hxssank/spark/electronics/boost-prototype/drc-parity-report.txt

** Drc report for spark_boost_rev_a.kicad_pcb **
** Created on 2026-10-30T02:46:36 **
** Report includes: Errors, Warnings **

** Found 0 DRC violations **

** Found 0 unconnected pads **

** Found 0 Footprint errors **

** Ignored checks **
    - None

** End of Report **
