hxssank/spark/electronics/boost-prototype/erc-report.txt

ERC report (2026-10-30T02:46:34, Encoding UTF8)
Report includes: Errors, Warnings

***** Sheet /

 ** ERC messages: 0  Errors 0  Warnings 0

 ** Ignored checks:
    - Global label only appears once in the schematic
    - Four connection points are joined together
    - SPICE model issue
    - Assigned footprint doesn't match footprint filters
