hxssank/spark/electronics/boost-prototype/reports/drill-report.txt

Drill report for spark_boost_rev_a.kicad_pcb
Created on 2026-11-09T16:06:39

Copper Layer Stackup:
    =============================================================
    L1 :  F.Cu                      front
    L2 :  In1.Cu                    in1
    L3 :  In2.Cu                    in2
    L4 :  B.Cu                      back

Drill file 'spark_boost_rev_a-PTH.drl' contains
    plated through holes:
    =============================================================
    T1  0.200mm  0.0079"  (2 holes))
    T2  0.250mm  0.0098"  (29 holes))
    T3  0.300mm  0.0118"  (10 holes))
    T4  1.500mm  0.0591"  (4 holes))

    Total plated holes count 45

Drill file 'spark_boost_rev_a-NPTH.drl' contains
    unplated through holes:
    =============================================================

    Total unplated holes count 0
