hxssank/spark/sourcing/digikey-canada-bench-rev-a.csv

Reference | Quantity per board | Suggested quantity including spares | Manufacturer part number | Description | DigiKey Canada URL | Sourcing status checked 2026-10-30 | Scope
U1 | 1 | 2 | TPS61288LRQQR | Boost converter | https://www.digikey.ca/en/products/detail/texas-instruments/TPS61288LRQQR/15856656 | Listed in stock; CAD 3.31 at qty 1 | Bench boost revision A only; not a complete power bank; choose Cut Tape; PCB and assembly excluded
L1 | 1 | 2 | XAL1060-222MEC | 2.2 uH power inductor | https://www.digikey.ca/en/products/detail/coilcraft/XAL1060-222MEC/15794549 | Exact BOM part; Canada page unavailable to research tool; stock and price unverified | Bench boost revision A only; not a complete power bank; choose Cut Tape; PCB and assembly excluded
C1 C5 C6 C7 C8 C9 C10 | 7 | 10 | GRM32ER71E226KE15K | 22 uF 25 V X7R 1210 | https://www.digikey.ca/en/products/detail/murata-electronics/GRM32ER71E226KE15K/13904980 | HOLD: out of stock; K packaging variant of BOM L; effective capacitance still requires validation | Bench boost revision A only; not a complete power bank; choose Cut Tape; PCB and assembly excluded
C2 C4 | 2 | 10 | CC0402KRX7R8BB104 | 100 nF 25 V X7R 0402 | https://www.digikey.ca/en/products/detail/yageo/CC0402KRX7R8BB104/5698948 | Selected to match previously unspecified BOM value; verify checkout stock | Bench boost revision A only; not a complete power bank; choose Cut Tape; PCB and assembly excluded
C3 | 1 | 5 | 0603ZD475KAT2A | 4.7 uF 10 V X5R 0603 | https://www.digikey.ca/en/products/detail/kyocera-avx/0603ZD475KAT2A/3080849 | HOLD: listed out of stock; replacement requires VCC effective-capacitance review | Bench boost revision A only; not a complete power bank; choose Cut Tape; PCB and assembly excluded
R1 | 1 | 10 | RT0402BRD07110KL | 110 kohm 0.1% 0402 | https://www.digikey.ca/en/products/detail/yageo/RT0402BRD07110KL/5926097 | Value confirmed by DigiKey model entry; Canada stock and price unverified | Bench boost revision A only; not a complete power bank; choose Cut Tape; PCB and assembly excluded
R2 | 1 | 10 | RT0402BRD0715KL | 15 kohm 0.1% 0402 | https://www.digikey.ca/en/products/detail/yageo/RT0402BRD0715KL/5252416 | DigiKey US listing confirmed; Canada stock and price unverified | Bench boost revision A only; not a complete power bank; choose Cut Tape; PCB and assembly excluded
R3 | 1 | 10 | RT0402BRD0716K5L | 16.5 kohm 0.1% 0402 | https://www.digikey.ca/en/products/detail/yageo/RT0402BRD0716K5L/1069059 | DigiKey regional listing confirmed; Canada stock and price unverified | Bench boost revision A only; not a complete power bank; choose Cut Tape; PCB and assembly excluded
R4 | 1 | 10 | RC0402FR-0712K4L | 12.4 kohm 1% 0402 | https://www.digikey.ca/en/products/detail/yageo/RC0402FR-0712K4L/2827623 | Listed in stock; CAD 0.34 for qty 10 | Bench boost revision A only; not a complete power bank; choose Cut Tape; PCB and assembly excluded
R5 | 1 | 10 | RC0402FR-07100KL | 100 kohm 1% 0402 | https://www.digikey.ca/en/products/detail/yageo/RC0402FR-07100KL/729473 | Canada listing confirmed; verify checkout stock | Bench boost revision A only; not a complete power bank; choose Cut Tape; PCB and assembly excluded
C11 | 1 | 10 | GRM1555C1H822JE01D | 8.2 nF 50 V C0G 0402 | https://www.digikey.ca/en/products/detail/murata-electronics/GRM1555C1H822JE01D/16033667 | Canada category and regional product confirmed; verify checkout stock | Bench boost revision A only; not a complete power bank; choose Cut Tape; PCB and assembly excluded
C12 | 1 | 10 | CC0402JRNPO9BN100 | 10 pF 50 V C0G 0402 | https://www.digikey.ca/en/products/detail/yageo/CC0402JRNPO9BN100/302748 | Canada listing confirmed; verify checkout stock | Bench boost revision A only; not a complete power bank; choose Cut Tape; PCB and assembly excluded
