hxssank/spark/sourcing/parts-list.csv

id | stage | item | part_or_search_target | quantity | unit | required_spec | aliexpress_search_text | aliexpress_search_url | primary_source_url | verification | budget_line_min_cad | budget_line_max_cad | notes | price_cad | shipping_cad | tax_cad | landed_cad
B01 | sample | Battery | GNB8501S60WHV | 4 | cells | 1S1P 850mAh 3.8V LiHV; 66x18x7.7mm; A30; manufacturer advertises 60C and 1C-5C charge | GNB 850mAh 1S 3.8V 60C A30 GNB8501S60WHV | https://www.aliexpress.com/w/wholesale-GNB-850mAh-1S-3.8V-60C-A30-GNB8501S60WHV.html | https://www.gaoneng.shop/products/gaoneng-gnb-lihv-1s-3.8v-850mah-60c-a30-cabled-lipo-battery-long-range | manufacturer specification verified; supplier unverified | 40 | 65 | One small sample pack; confirm exact model and dimensions including leads; no production qualification
B02 | sample | Battery mating lead | GNB A30-F8080 or A30-F | 2 | leads | Female mating side for device; red/black polarity verified by meter; adequate wire gauge for measured current | GNB A30 F8080 female cable connector | https://www.aliexpress.com/w/wholesale-GNB-A30-F8080-female-cable-connector.html | https://www.gaoneng.shop/products/gaoneng-a30-connector-adapter-for-fpv-whoops-quads-lipo-battery | manufacturer variant verified; wire rating unresolved | 8 | 15 | A30 joint and supplied leads need temperature and voltage-drop measurement; do not assume a connector current from C rating
B03 | sample | Charging adapter | GNB A30-PH2.0 | 1 | adapter | A30 female to PH2.0 male; charging only at 0.8A | GNB A30 PH2.0 charging adapter | https://www.aliexpress.com/w/wholesale-GNB-A30-PH2.0-charging-adapter.html | https://www.gaoneng.shop/products/gaoneng-a30-connector-adapter-for-fpv-whoops-quads-lipo-battery | manufacturer variant verified; supplier unverified | 4 | 8 | Never put PH2.0 adapter in high-current discharge path
B04 | sample | Short phone cable | USB-C to USB-C 60W 3A | 1 | cable | 0.15-0.3m; 3A rating; both CC orientations pass PD testing | USB C to USB C 60W 3A 0.2m cable | https://www.aliexpress.com/w/wholesale-USB-C-to-USB-C-60W-3A-0.2m-cable.html |  | procurement requirement; seller unverified | 6 | 12 | Select a known brand and verify cable voltage drop; no magnetic tip
B05 | sample | Insulation | Polyimide tape and electrical-grade fishpaper | 1 | small set | 0.1-0.3mm fishpaper plus tape; use in insulation allowance | battery fish paper insulation 0.2mm polyimide tape | https://www.aliexpress.com/w/wholesale-battery-fish-paper-insulation-0.2mm-polyimide-tape.html |  | procurement requirement; seller unverified | 8 | 15 | Insulate cell and PCB from eventual aluminium; avoid compressing pouch
B06 | sample | Wire | 20AWG stranded silicone copper | 1 | small red black set | Short flexible battery leads; actual conductor cross-section checked | 20AWG silicone copper wire red black | https://www.aliexpress.com/w/wholesale-20AWG-silicone-copper-wire-red-black.html |  | procurement requirement; seller unverified | 8 | 15 | Keep high-current loop short; gauge does not replace measured connector temperature
B07 | sample | Printed enclosure material | PETG | 1 | prototype allocation | Use existing filament if suitable; cold fit first | PETG 1.75mm filament black | https://www.aliexpress.com/w/wholesale-PETG-1.75mm-filament-black.html |  | procurement requirement; seller unverified | 5 | 10 | Prototype material allocation, not a spool quote; printed case is not thermal validation
B08 | sample | Case fasteners | M2x3 socket-head cap screw | 10 | screws | 2 used; head diameter about3.8mm; head height at most2mm; length3mm | M2x3 socket head cap screw | https://www.aliexpress.com/w/wholesale-M2x3-socket-head-cap-screw.html |  | CAD requirement; seller unverified | 6 | 10 | Printed carrier blind1.6mm pilots; no heat-set inserts in fit prototype
T01 | tools_if_missing | Cell charger | VIFLY WhoopStor 3 | 1 | charger | 0.3-1.3A per port; 4.20V and 4.35V; storage mode; PH2.0/BT2.0 | VIFLY WhoopStor 3 | https://www.aliexpress.com/w/wholesale-VIFLY-WhoopStor-3.html | https://viflydrone.com/products/vifly-whoopstor-6-ports-1s-battery-storage-charger-discharger | manufacturer specification verified; supplier unverified | 45 | 70 | Initial plan 0.8A and 4.20V; official product page showed selected variant sold out
T02 | tools_if_missing | Charger power source | USB-C PD 45W or greater | 1 | adapter | Must meet WhoopStor input 9-20V and minimum40W; verify actual offered profiles with charger; 12V profile preferred | USB C PD 65W charger 12V 15V 20V | https://www.aliexpress.com/w/wholesale-USB-C-PD-65W-charger-12V-15V-20V.html | https://viflydrone.com/products/vifly-whoopstor-6-ports-1s-battery-storage-charger-discharger | charger input verified; source SKU unselected | 25 | 45 | Reuse compatible source; a 5V-only USB source cannot operate WhoopStor
T03 | tools_if_missing | Charger cable | USB-C to USB-C 60W 3A | 1 | cable | 0.5-1m; 3A and proper CC wiring | USB C to USB C 60W 3A cable | https://www.aliexpress.com/w/wholesale-USB-C-to-USB-C-60W-3A-cable.html |  | procurement requirement; seller unverified | 6 | 12 | Separate from short phone cable
T04 | tools_if_missing | USB PD meter and trigger | FNIRSI FNB58 | 1 | meter | Manufacturer specifies4-28V and0-7A; PD trigger and energy logging | FNIRSI FNB58 USB tester | https://www.aliexpress.com/w/wholesale-FNIRSI-FNB58-USB-tester.html | https://www.fnirsi.com/products/fnb58 | manufacturer specification verified; supplier unverified | 55 | 85 | Protocol triggers connect to test load, never blindly to phone; meter is not an electronic load
T05 | tools_if_missing | DC electronic load | ATORCH DL24 150W | 1 | load kit | Manufacturer manual specifies2-200V0-20A; choose correct DL24 variant and required auxiliary supply | ATORCH DL24 150W electronic load kit | https://www.aliexpress.com/w/wholesale-ATORCH-DL24-150W-electronic-load-kit.html | https://en.atorch.cn/upload/20241224153104.pdf | manufacturer manual indexed; live PDF fetch timed out; supplier unverified | 45 | 80 | Budget includes auxiliary supply allowance; verify constant-current operation and leads before battery test
T06 | tools_if_missing | Contact thermometer | UNI-T UT320D | 1 | meter with two probes | Dual K/J input; insulate conductive probe beads from exposed conductors | UNI T UT320D dual thermocouple | https://www.aliexpress.com/w/wholesale-UNI-T-UT320D-dual-thermocouple.html | https://meters.uni-trend.com/product/ut320-series | manufacturer specification verified; supplier unverified | 35 | 60 | Measure cell and converter; case/connector in separate repeated runs or add logger
H01 | hold | Custom power electronics | See electronics/power-design.md | 1 | development design | Minimum25W at USB-C after losses; 1S input; charger/protection/thermal control required | 1S 30W USB C PD power bank module schematic | https://www.aliexpress.com/w/wholesale-1S-30W-USB-C-PD-power-bank-module-schematic.html |  | circuit selection and PCB review required |  |  | Generic module search is for comparison only; no module qualified to fit or meet output target
H02 | hold | PCB fabrication and assembly | Custom board | 1 | prototype lot | Copper weight, layer count, stencil, assembly and test set by final electrical design |  |  |  | not released for fabrication |  |  | Get fabrication quote only after circuit and layout review; excludes machining and laboratory certification
H03 | hold | Bench supply for board bring-up | Current-limited adjustable supply | 1 | supply if missing | At least0-5V and10A for full-power1S emulation; output-off control; reverse-current handling reviewed |  |  |  | requirement only; no qualified SKU |  |  | Do not connect charging output to a source-only supply without blocking or suitable battery simulator
D01 | hold | Colour OLED glass | RB060-6464TDDBG01 | 1 | set | 15x17.5x1.2mm nominal glass; active10.73x10.73mm;64x64RGB;SPI;20pin0.5mm FPC |  |  | https://www.ronboe.com/shop/rb060-6464tddbg01/ | Manufacturer listing checked2026-10-28; drawing and sample required |  |  | Rear PCB bay candidate; supply rails,pinout,tail,maximum dimensions,stock,lifecycle and landed cost unverified
D02 | hold | Battery fuel gauge | MAX17260 TDFN plus Kelvin shunt and NTC | 1 | set | 3x3mm TDFN;1mohm current sense candidate; pair learned state with identified cell |  |  | https://www.analog.com/media/en/technical-documentation/data-sheets/max17260.pdf | Architecture candidate; not on boost PCB |  |  | Gauge belongs with identified protected cartridge; A30 alone does not identify a swapped cell; health unknown until learned
D03 | hold | Display control and power | Low-power SPI MCU and gated OLED supply | 1 | set | MCU with SPI and I2C; panel rails match exact supplier datasheet; button wake; power budget measured |  |  |  | Requirements only; no SKU selected |  |  | Reserve connector,decoupling,power sequencing and firmware; no functional screen electronics implemented
D04 | hold | Display lens and mounting | Clear insulating lens and removable frame | 1 | set | Fit exact panel maximum envelope; lens stays with sleeve and panel with carrier; sleeve slides down without unplugging display; no pressure on cell |  |  |  | CAD candidate; sample fit required |  |  | CAD service path tested; actual flex route,adhesion,impact resistance and button access remain unverified
N01 | hold | Thin power inductor | XGL7030-222MEC | 1 | candidate | 2.2uH; maximum body8x8x3.1mm; maxDCR8.8mohm; Isat30percent14.5A |  |  | https://www.coilcraft.com/getmedia/63e6e233-cff1-40b9-9e5d-f0f490094f44/xgl7030.pdf | Manufacturer documentation checked2026-10-29; research candidate; not on routed PCB |  |  | First thin-coil experiment; requires tighter overload limit or saturation qualification; hot winding and enclosed temperature untested
N02 | hold | Lower-loss smaller-area inductor alternative | XGL6060-222MEC | 1 | candidate | 2.2uH; maximum body6.91x6.71x6.1mm; maxDCR4.8mohm; Isat30percent16A |  |  | https://www.coilcraft.com/getmedia/329fe97c-7311-4726-9bf3-37718f42b168/xgl6060.pdf | Manufacturer documentation checked2026-10-29; research candidate; not on routed PCB |  |  | Alternative to N01; reduces area but not height; fault current and temperature require qualification
N03 | hold | Smaller capacitor candidate | C2012X5R1E226M125AC |  | candidate | 22uF25V X5R0805; tolerance20percent; maximum body2.2x1.45x1.45mm |  |  | https://product.tdk.com/en/search/capacitor/ceramic/mlcc/info?part_no=C2012X5R1E226M125AC | Manufacturer documentation checked2026-10-29; research candidate; not on routed PCB |  |  | Quantity unresolved; output bank must retain at least60uF effective at9V after derating; input substitution also needs ripple verification
N04 | hold | Smaller capacitor alternative | GRM21BR61E226ME44L |  | candidate | 22uF25V X5R0805; tolerance20percent; maximum body2.2x1.45x1.45mm |  |  | https://search.murata.co.jp/Ceramy/image/img/A01X/G101/ENG/GRM21BR61E226ME44-01A.pdf | Manufacturer documentation checked2026-10-29; research candidate; not on routed PCB |  |  | Alternative to N03; quantity and effective capacitance unresolved; no six-part replacement approval
N05 | hold | Combined display and USB-PD MCU | STM32G071GBU6N | 1 | candidate | 4x4mm UFQFPN28;128KBflash;36KBRAM;SPI;I2C;UCPD |  |  | https://www.st.com/en/microcontrollers-microprocessors/stm32g071gb.html | Manufacturer documentation checked2026-10-29; research candidate; not on routed PCB |  |  | Use N pinout with bothCC pins; requires firmware and hardware fault shutdown; pin allocation and low-power supply not designed
N06 | hold | Source-only USB-C protection and gate driver | TCPP02-M18 | 1 | candidate | 3.5x3.5x0.55mm; CC protection; external VBUS FET driver and discharge |  |  | https://www.st.com/resource/en/datasheet/tcpp02-m18.pdf | Manufacturer documentation checked2026-10-29; research candidate; not on routed PCB |  |  | For source-only external-dock architecture with N05; external FETs and sensing remain
N07 | hold | Dual-role USB-C protection and gate driver alternative | TCPP03-M20 | 1 | candidate | 4x4x0.75mm; source and sink external NFET drivers; CC protection; discharge |  |  | https://www.st.com/resource/en/datasheet/tcpp03-m20.pdf | Manufacturer documentation checked2026-10-29; research candidate; not on routed PCB |  |  | Alternative to N06 if same port charges and supplies phone; interlocks and reverse-current blocking require design
N08 | hold | Optional onboard switching charger | BQ25628RYKR | 1 | candidate | 2.5x3mm WQFN;0.04-2A charge;3.50-4.80V regulation;1.5MHz |  |  | https://www.ti.com/lit/ds/symlink/bq25628.pdf | Manufacturer documentation checked2026-10-29; research candidate; not on routed PCB |  |  | Needs inductor and capacitors; main boost must bypass6A SYS battery path and use independently protected pack; charge ceiling includes tolerance; separate boost isolation needed because charger ship mode cannot disconnect it; inhibit charger during USB source mode
N09 | hold | Smaller existing fuel gauge package | MAX17260SEWL+T | 1 | candidate | 1.5x1.5mm9-WLP;0.4mm pitch;1mohm Kelvin shunt candidate |  |  | https://www.analog.com/media/en/technical-documentation/data-sheets/max17260.pdf | Manufacturer documentation checked2026-10-29; research candidate; not on routed PCB |  |  | Alternative package to D02;75percent chip-area reduction; separate protection and cartridge identity still required
N10 | hold | Integrated smart-cartridge gauge and protector alternative | MAX17311X+T | 1 | candidate | 1.7x2.5mm15-WLP;0.5mm pitch;1-Wire;64-bit uniqueID;standalone protection |  |  | https://www.analog.com/media/en/technical-documentation/data-sheets/max17300-max17313.pdf | Manufacturer documentation checked2026-10-29; research candidate; not on routed PCB |  |  | Alternative to separate MAX17260 and BQ2980; external FETs shunt NTC remain; verify configuration;24uAactive18uAhibernate; requires data contact
N11 | hold | Separate single-cell protector alternative | BQ2980 family; order code pending battery | 1 | candidate | 1.5x1.5x0.37mm;high-side NFET drive;separate current shunt |  |  | https://www.ti.com/lit/ds/symlink/bq2980.pdf | Manufacturer documentation checked2026-10-29; research candidate; not on routed PCB |  |  | Use with N09 instead of N10; fixed voltage thresholds and shunt must match selected cell; BQ298018 with 4.4 V OVP is not a universal choice
N12 | hold | Battery protection dual MOSFET candidate | SSM10N954L | 1 | candidate | 2.98x1.49x0.11mm;common-drain dualNFET;RSSmax2.75mohm atVgs4.5V25C |  |  | https://toshiba.semicon-storage.com/info/SSM10N954L_datasheet_en_20231010.pdf?did=70605&prodName=SSM10N954L | Manufacturer documentation checked2026-10-29; research candidate; not on routed PCB |  |  | Verify protector gate-drive compatibility and short-circuit behavior;13.5A absolute rating is not Spark continuous rating; assembly capability unverified
N13 | hold | Compact USB-C receptacle | USB4500-03-0-A | 1 | candidate | 6.50mm body length;3.16mm profile;0.80mm midmount offset;5AcollectiveVBUS |  |  | https://gct.co/connector/usb4500 | Manufacturer documentation checked2026-10-29; research candidate; not on routed PCB |  |  | Product page verified; drawing retrieval failed; width land pattern board cutout and1mmPCB compatibility unresolved
N14 | hold | Conditional OLED boost supply | TPS61046YFFR | 1 | candidate | 0.80x1.20mm nominalWCSP;output through28V;fixed12V option;true shutdown disconnect |  |  | https://www.ti.com/lit/ds/symlink/tps61046.pdf | Manufacturer documentation checked2026-10-29; research candidate; not on routed PCB |  |  | Requires exact Ronbo electrical specification; not confirmation panel needs12V; needs inductor and capacitors; check current and sequencing
N15 | hold | Lower-power integrated charger and boost alternative | BQ25638 | 1 | candidate | 2.07x2.36mm DSBGA;3.84-9.6Vboost;7A maximum recommended continuous battery discharge |  |  | https://www.ti.com/lit/ds/symlink/bq25638.pdf | Manufacturer documentation checked2026-10-29; research candidate; not on routed PCB |  |  | Separate approximately15W evaluation only; cannot sustain25W from3V cell; may replace two converters and inductors with one each
