hxssank/spark/mechanical/exports/spark_assembly.step

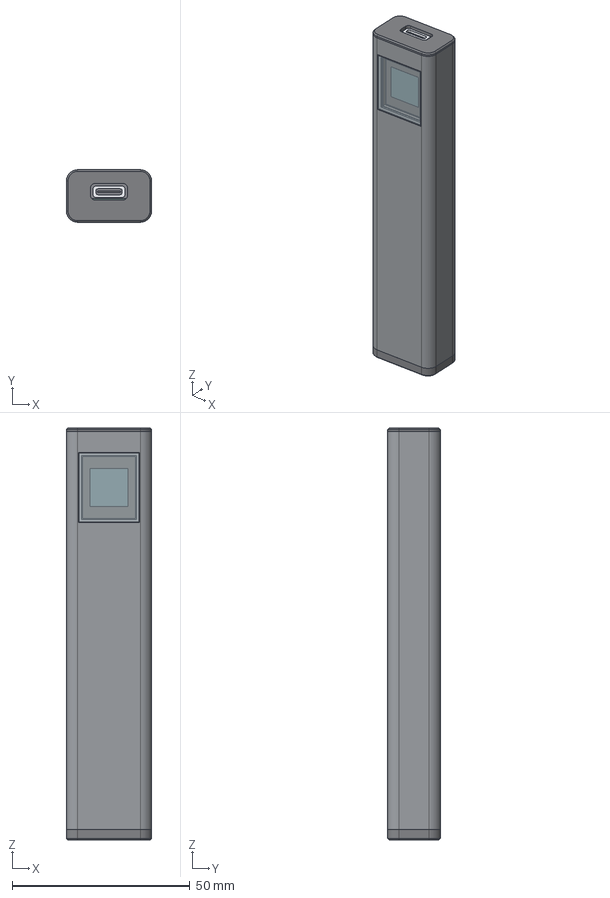
[picture p2: CAD file, 2026-11-09]
mechanical/exports/spark_assembly.step
24.0 x 14.8 x 116.0 mm
u1_reference
inductor_reference
input_cap_reference
c2_unmeasured_reference
c3_unmeasured_reference
c4_unmeasured_reference
c5_reference
c6_reference
c7_reference
c8_reference
c9_reference
c10_reference
r1_unmeasured_reference
r2_unmeasured_reference
r3_unmeasured_reference
jp1_pad_reference
r4_unmeasured_reference
c11_unmeasured_reference
c12_unmeasured_reference
r5_unmeasured_reference
j1_pad_reference
j2_pad_reference
j3_pad_reference
j4_pad_reference
j5_pad_reference
a30_unmeasured_reference
display_glass_reference
display_active_reference
display_lens_reference
display_fpc_keepout_reference
sleeve
carrier
front_cover
bottom_cap
battery_reference
pcb_reference
usb_reference
usb_tongue_reference
