hxssank/spark/mechanical/exports/usb_reference.step

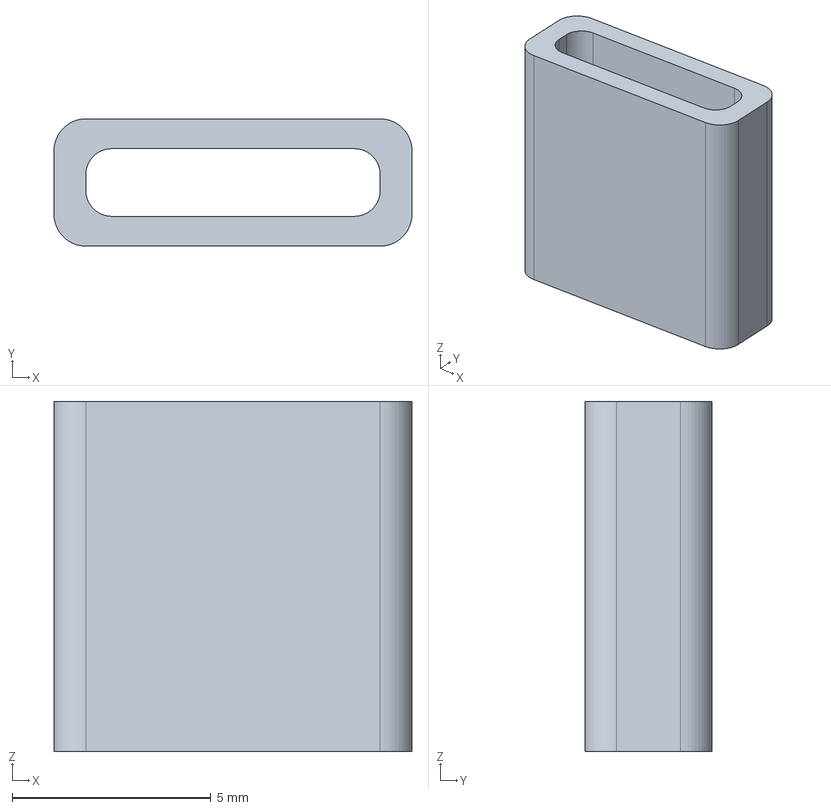
[picture p4: CAD file, 2026-11-09]
mechanical/exports/usb_reference.step
9.00 x 3.20 x 8.80 mm
