hxssank/spark/mechanical/exports/j5_pad_reference.step

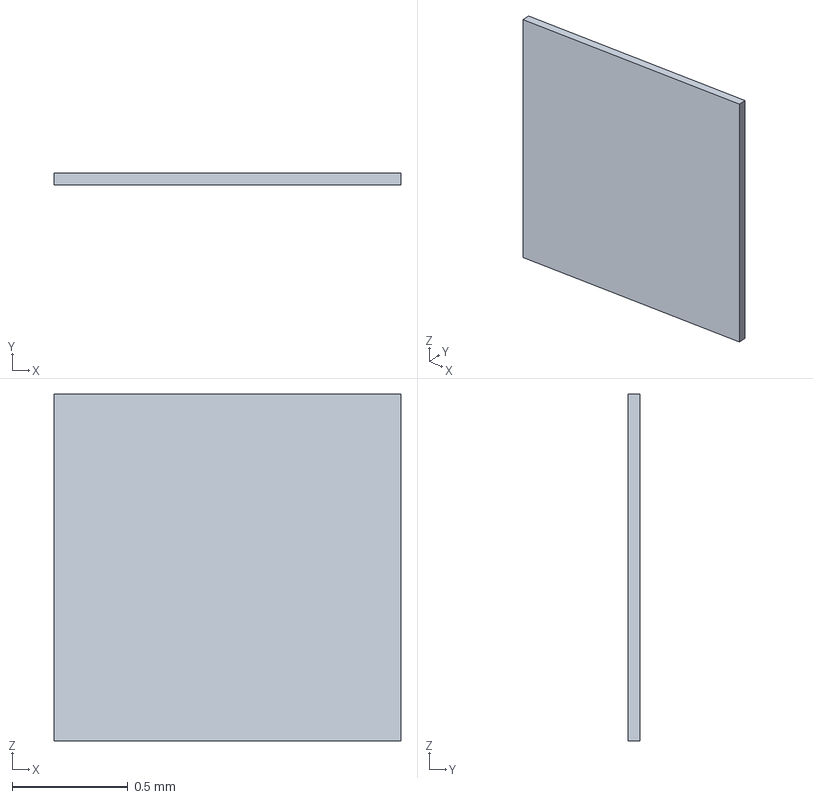
[picture p6: CAD file, 2026-11-09]
mechanical/exports/j5_pad_reference.step
1.50 x 0.05 x 1.50 mm
