hxssank/spark/mechanical/compact-exports/spark_300_packing.step

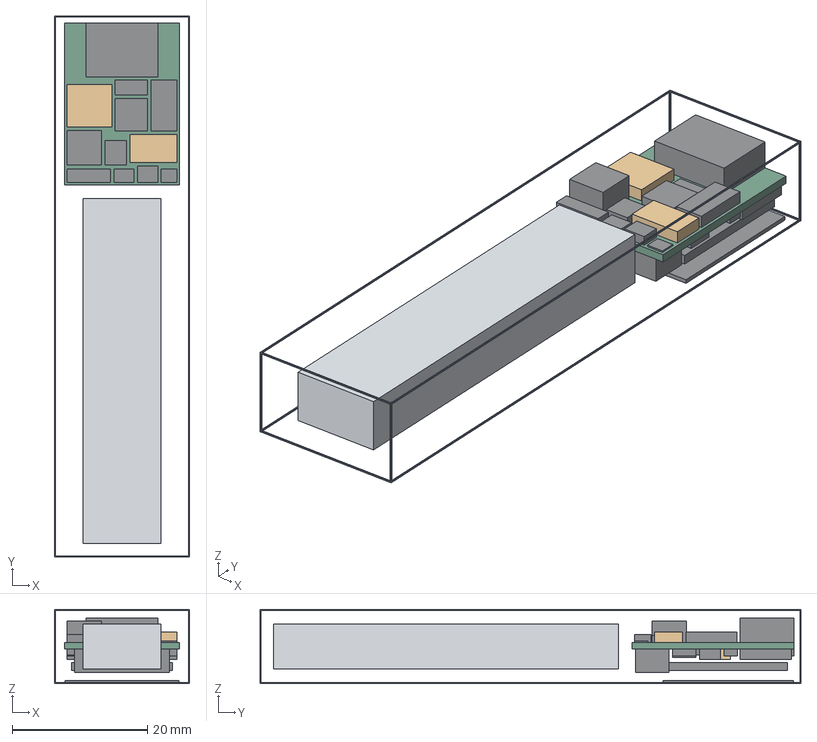
[picture p7: CAD file, 2026-11-09]
mechanical/compact-exports/spark_300_packing.step
20.0 x 80.0 x 11.0 mm
case_envelope_frame
cell_envelope
board_reservation
JBAT_front_reservation
RSBAT_front_reservation
QBAT_front_reservation
TH_front_reservation
L1_front_reservation
U1_front_reservation
CIN_front_reservation
COUT_front_reservation
MCU_front_reservation
SUP1_front_reservation
TEST_front_reservation
USB_front_reservation
USB_back_reservation
FPC_back_reservation
PD_back_reservation
QUSB_back_reservation
RSUSB_back_reservation
PACK_back_reservation
OLED_back_reservation
LOLED_back_reservation
COLED_back_reservation
LDO_back_reservation
WAKE_back_reservation
SUP2_back_reservation
SUP3_back_reservation
display_glass_reservation
display_lens_reservation
