hxssank/spark/mechanical/exports/c9_reference.step

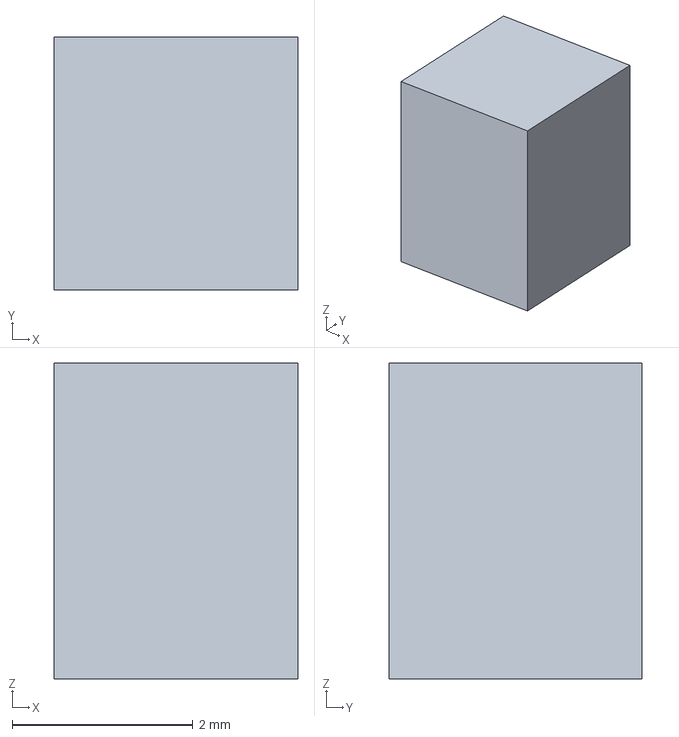
[picture p8: CAD file, 2026-11-09]
mechanical/exports/c9_reference.step
2.70 x 2.80 x 3.50 mm
