hxssank/spark/mechanical/exports/front_cover.step

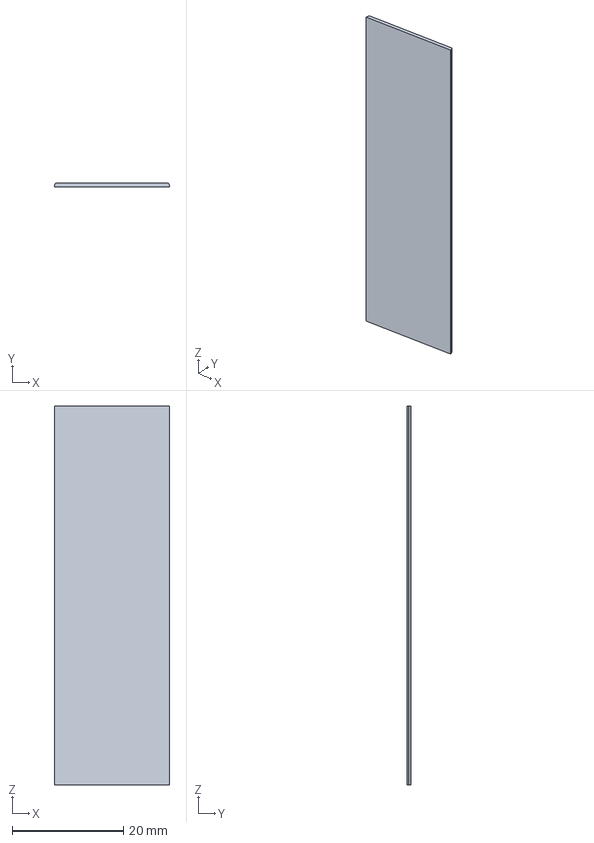
[picture p9: CAD file, 2026-11-09]
mechanical/exports/front_cover.step
20.7 x 0.8 x 68.0 mm
