hxssank/spark/mechanical/exports/inductor_reference.step

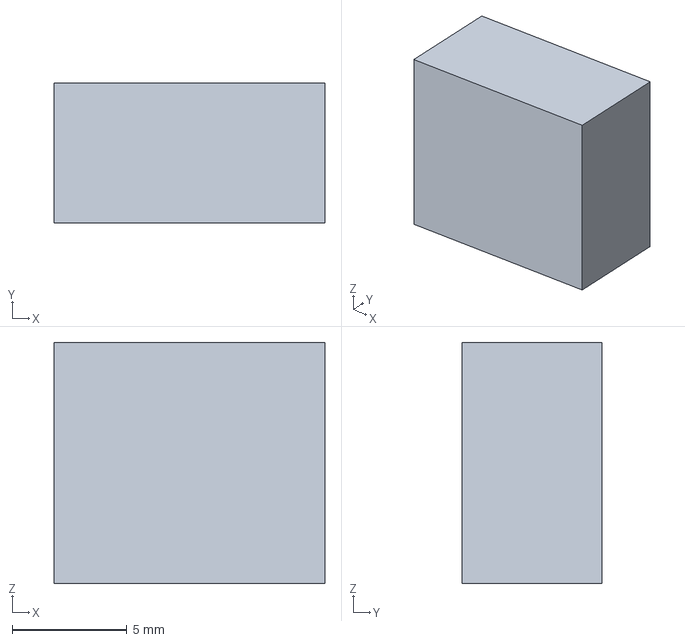
[picture p10: CAD file, 2026-11-09]
mechanical/exports/inductor_reference.step
11.8 x 6.10 x 10.5 mm
