hxssank/spark/mechanical/exports/c4_unmeasured_reference.step

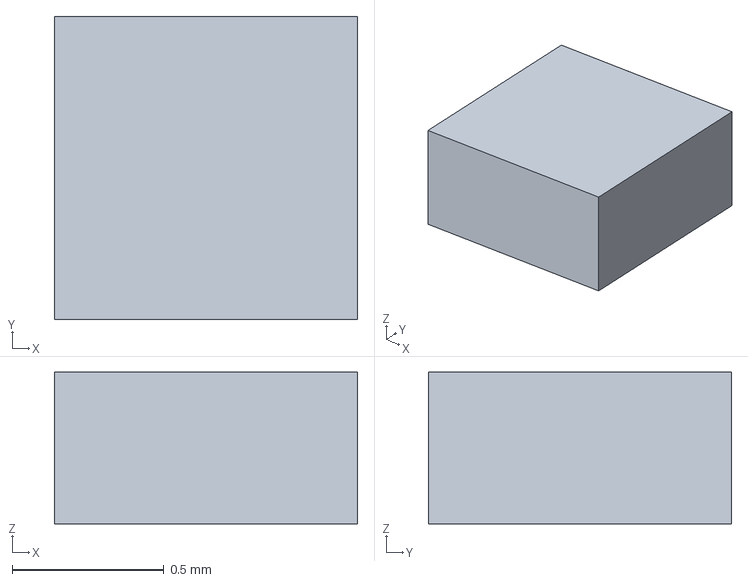
[picture p11: CAD file, 2026-11-09]
mechanical/exports/c4_unmeasured_reference.step
1.00 x 1.00 x 0.5 mm
