hxssank/spark/mechanical/exports/display_active_reference.step

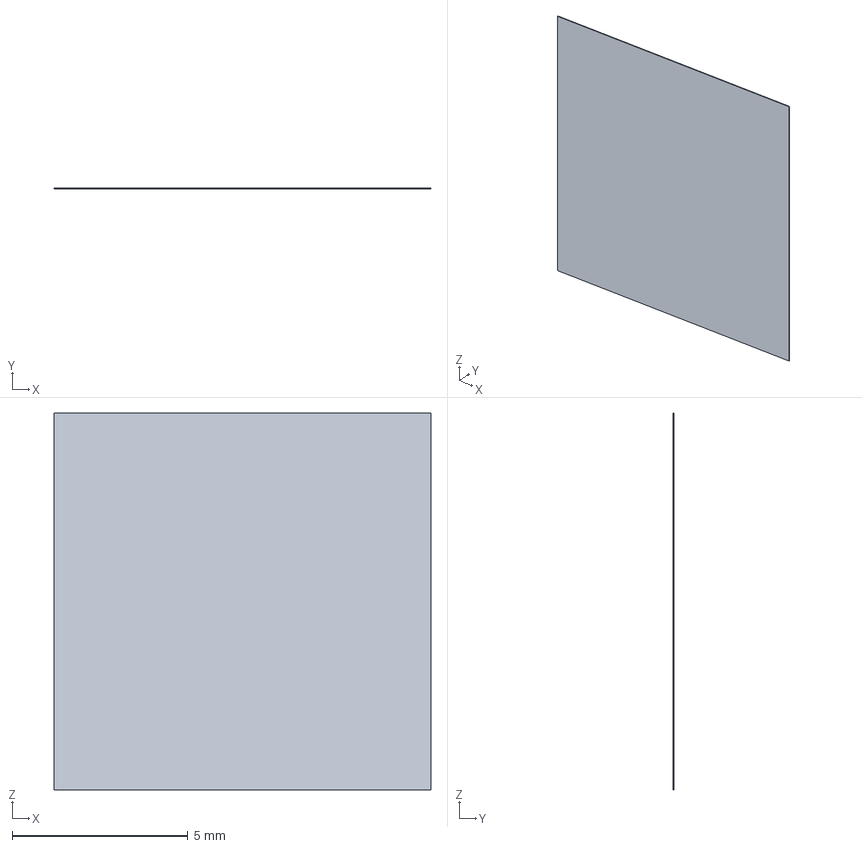
[picture p12: CAD file, 2026-11-09]
mechanical/exports/display_active_reference.step
10.7 x 0.03 x 10.7 mm
