hxssank/spark/mechanical/exports/battery_reference.step

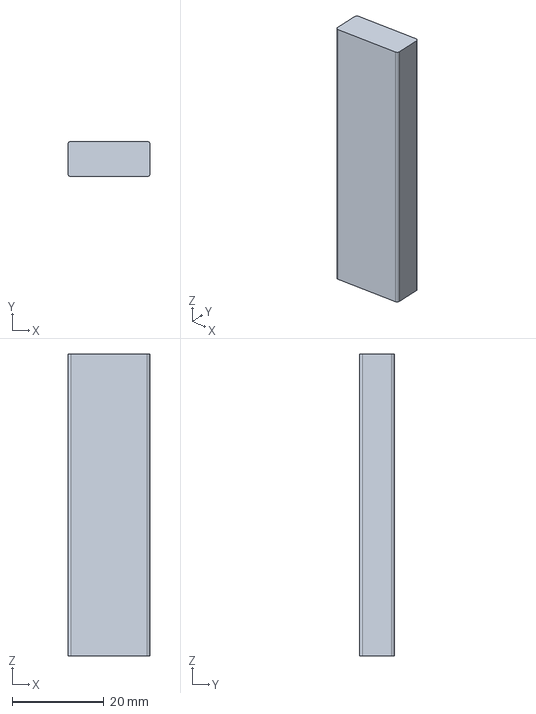
[picture p13: CAD file, 2026-11-09]
mechanical/exports/battery_reference.step
18.0 x 7.70 x 66.0 mm
