hxssank/spark/mechanical/exports/j2_pad_reference.step

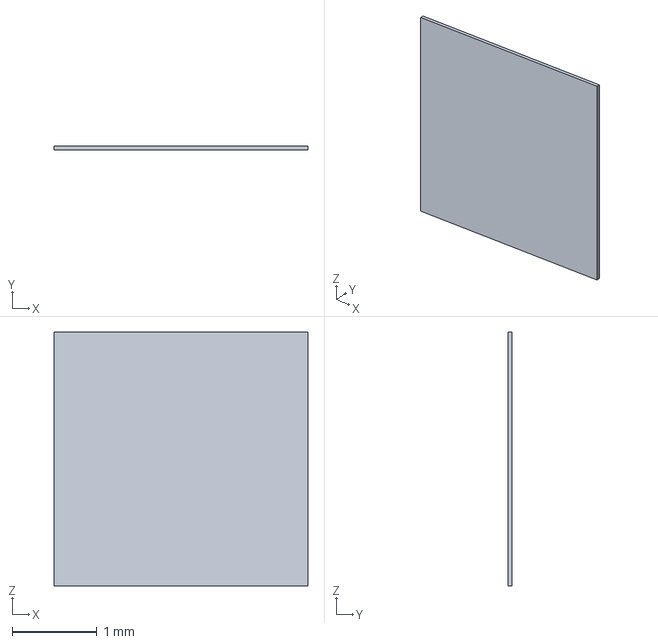
[picture p14: CAD file, 2026-11-09]
mechanical/exports/j2_pad_reference.step
3.00 x 0.05 x 3.00 mm
