hxssank/spark/mechanical/exports/pcb_reference.step

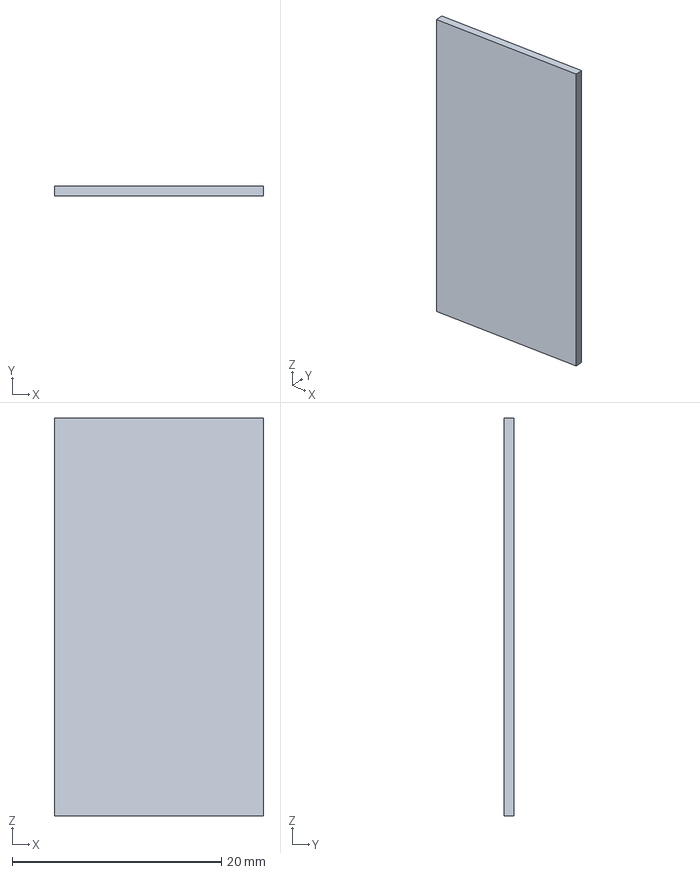
[picture p15: CAD file, 2026-11-09]
mechanical/exports/pcb_reference.step
20.0 x 1.00 x 38.0 mm
