hxssank/spark/mechanical/exports/carrier.step

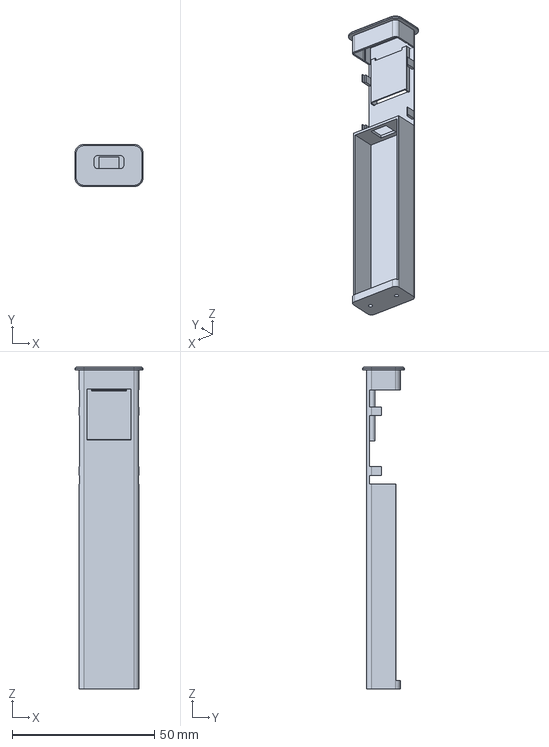
[picture p16: CAD file, 2026-11-09]
mechanical/exports/carrier.step
24.0 x 14.8 x 113.0 mm
