hxssank/spark/mechanical/exports/sleeve.step

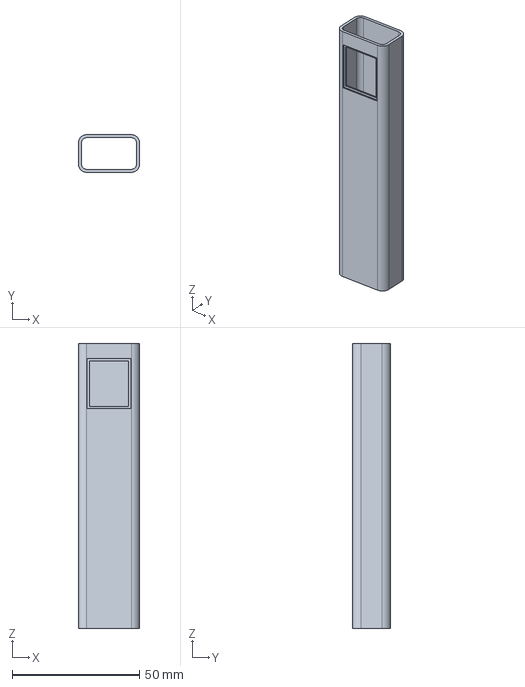
[picture p17: CAD file, 2026-11-09]
mechanical/exports/sleeve.step
24.0 x 14.8 x 112.0 mm
