hxssank/spark/mechanical/exports/u1_reference.step

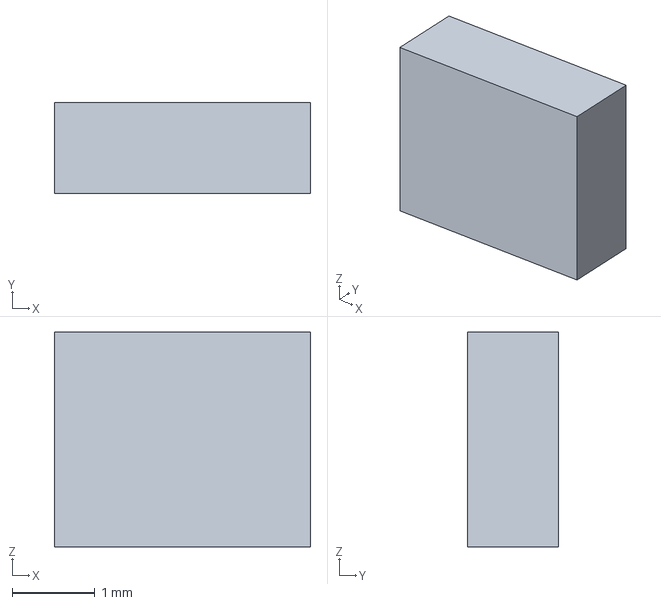
[picture p18: CAD file, 2026-11-09]
mechanical/exports/u1_reference.step
3.10 x 1.10 x 2.60 mm
