hxssank/spark/mechanical/exports/display_lens_reference.step

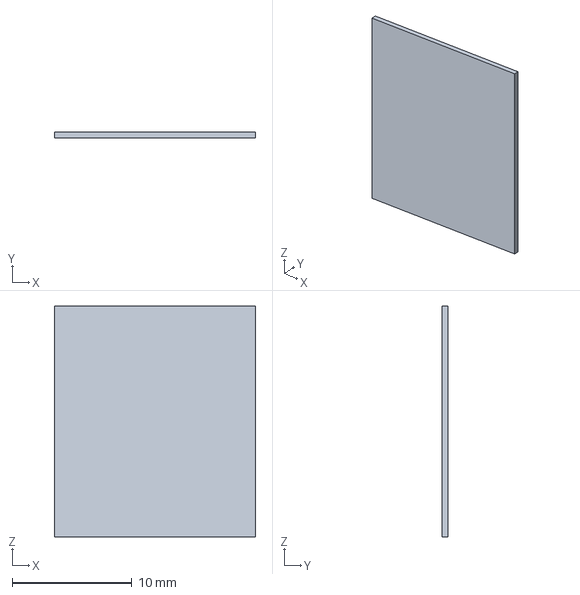
[picture p19: CAD file, 2026-11-09]
mechanical/exports/display_lens_reference.step
16.8 x 0.5 x 19.3 mm
