hxssank/spark/mechanical/exports/jp1_pad_reference.step

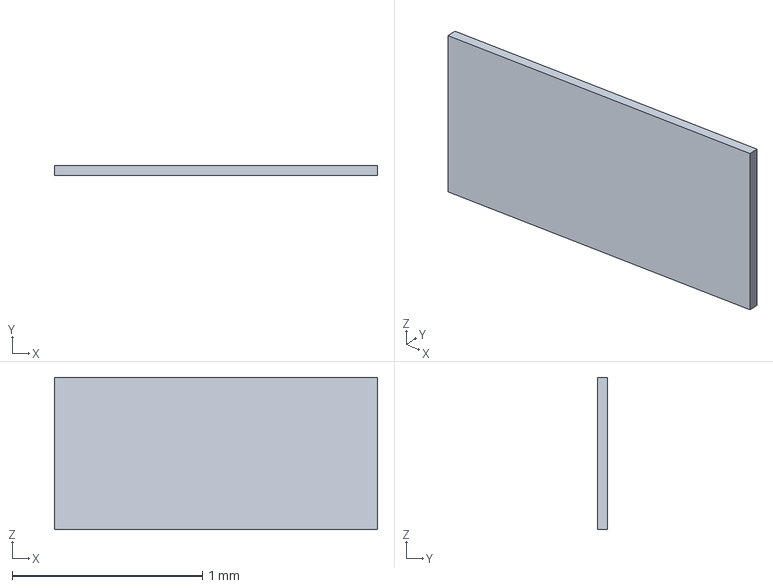
[picture p20: CAD file, 2026-11-09]
mechanical/exports/jp1_pad_reference.step
1.70 x 0.05 x 0.8 mm
