hxssank/spark/mechanical/exports/c3_unmeasured_reference.step

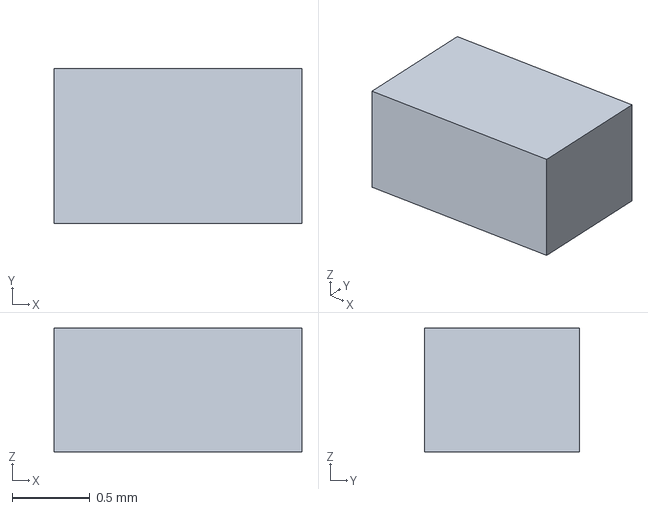
[picture p21: CAD file, 2026-11-09]
mechanical/exports/c3_unmeasured_reference.step
1.60 x 1.00 x 0.8 mm
