hxssank/spark/mechanical/exports/a30_unmeasured_reference.step

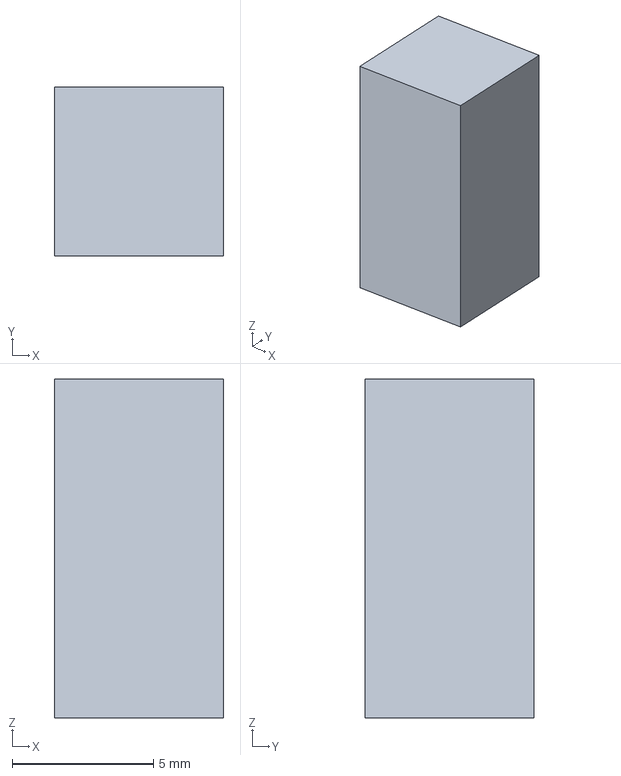
[picture p22: CAD file, 2026-11-09]
mechanical/exports/a30_unmeasured_reference.step
6.00 x 6.00 x 12.0 mm
