hxssank/spark/mechanical/exports/display_fpc_keepout_reference.step

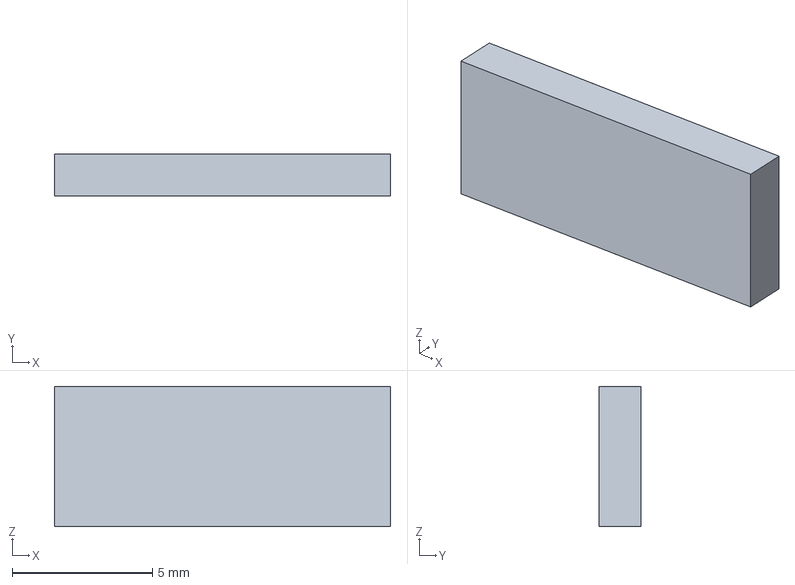
[picture p23: CAD file, 2026-11-09]
mechanical/exports/display_fpc_keepout_reference.step
12.0 x 1.50 x 5.00 mm
