hxssank/spark/mechanical/exports/usb_tongue_reference.step

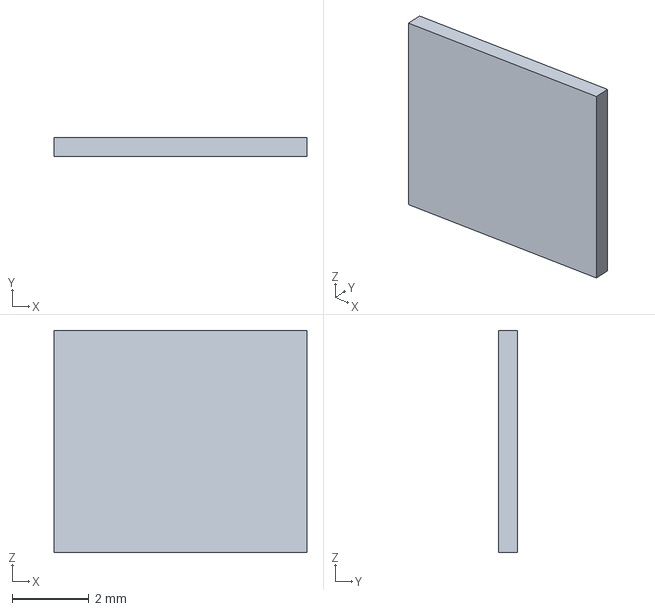
[picture p24: CAD file, 2026-11-09]
mechanical/exports/usb_tongue_reference.step
6.60 x 0.5 x 5.80 mm
