hxssank/spark/mechanical/exports/bottom_cap.step

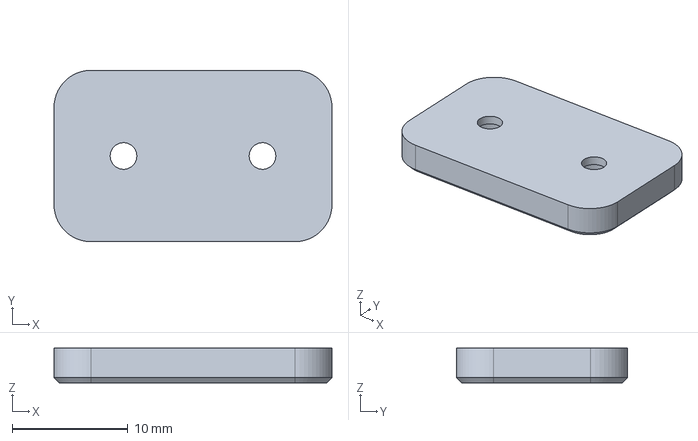
[picture p25: CAD file, 2026-11-09]
mechanical/exports/bottom_cap.step
24.0 x 14.8 x 3.00 mm
