hxssank/spark/mechanical/exports/display_glass_reference.step

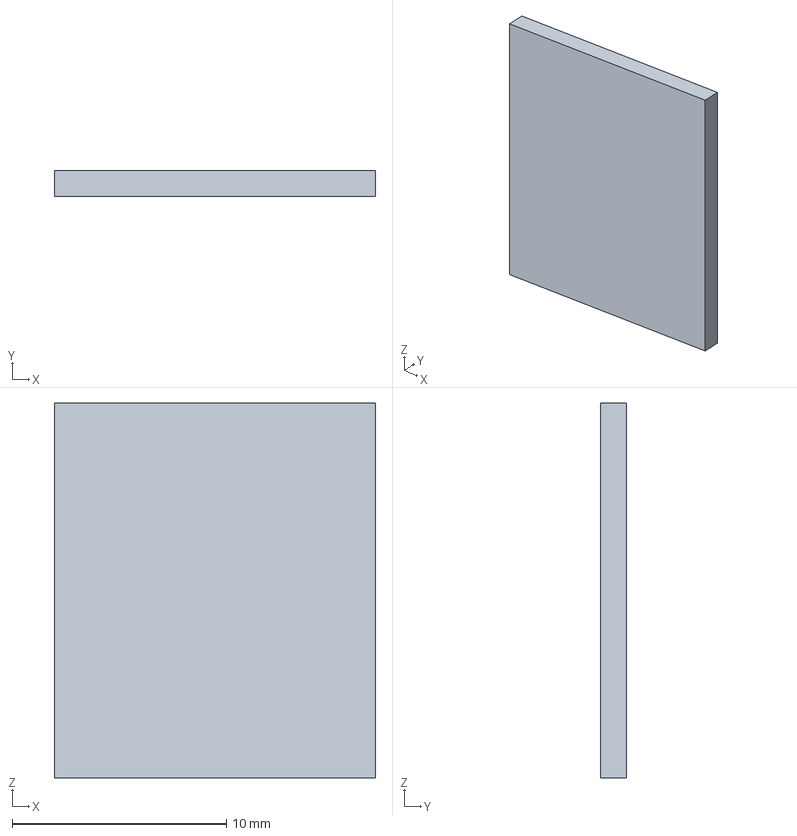
[picture p26: CAD file, 2026-11-09]
mechanical/exports/display_glass_reference.step
15.0 x 1.20 x 17.5 mm
