hxssank/spark/(list of files, cad)

Other CAD files:
mechanical/exports/c8_reference.step
mechanical/exports/c2_unmeasured_reference.step
mechanical/exports/j1_pad_reference.step
mechanical/exports/r3_unmeasured_reference.step
mechanical/exports/r2_unmeasured_reference.step
mechanical/exports/r4_unmeasured_reference.step
mechanical/exports/c10_reference.step
mechanical/exports/j3_pad_reference.step
mechanical/exports/c5_reference.step
mechanical/exports/input_cap_reference.step
mechanical/exports/c11_unmeasured_reference.step
mechanical/exports/c6_reference.step
mechanical/exports/r5_unmeasured_reference.step
mechanical/exports/j4_pad_reference.step
mechanical/exports/c7_reference.step
mechanical/exports/r1_unmeasured_reference.step
mechanical/exports/c12_unmeasured_reference.step
mechanical/print_parts/bottom_cap.stl
mechanical/print_parts/carrier.stl
mechanical/print_parts/front_cover.stl
mechanical/print_parts/sleeve.stl
