hxssank/spark/(list of files, drawings)

Other design files:
electronics/boost-prototype/reports/pcb-drc.json
