hxssank/spark/electronics/boost-prototype/spark_boost_rev_a.kicad_pcb

## KiCad design electronics/boost-prototype/spark_boost_rev_a.kicad_pcb (2026-11-09)

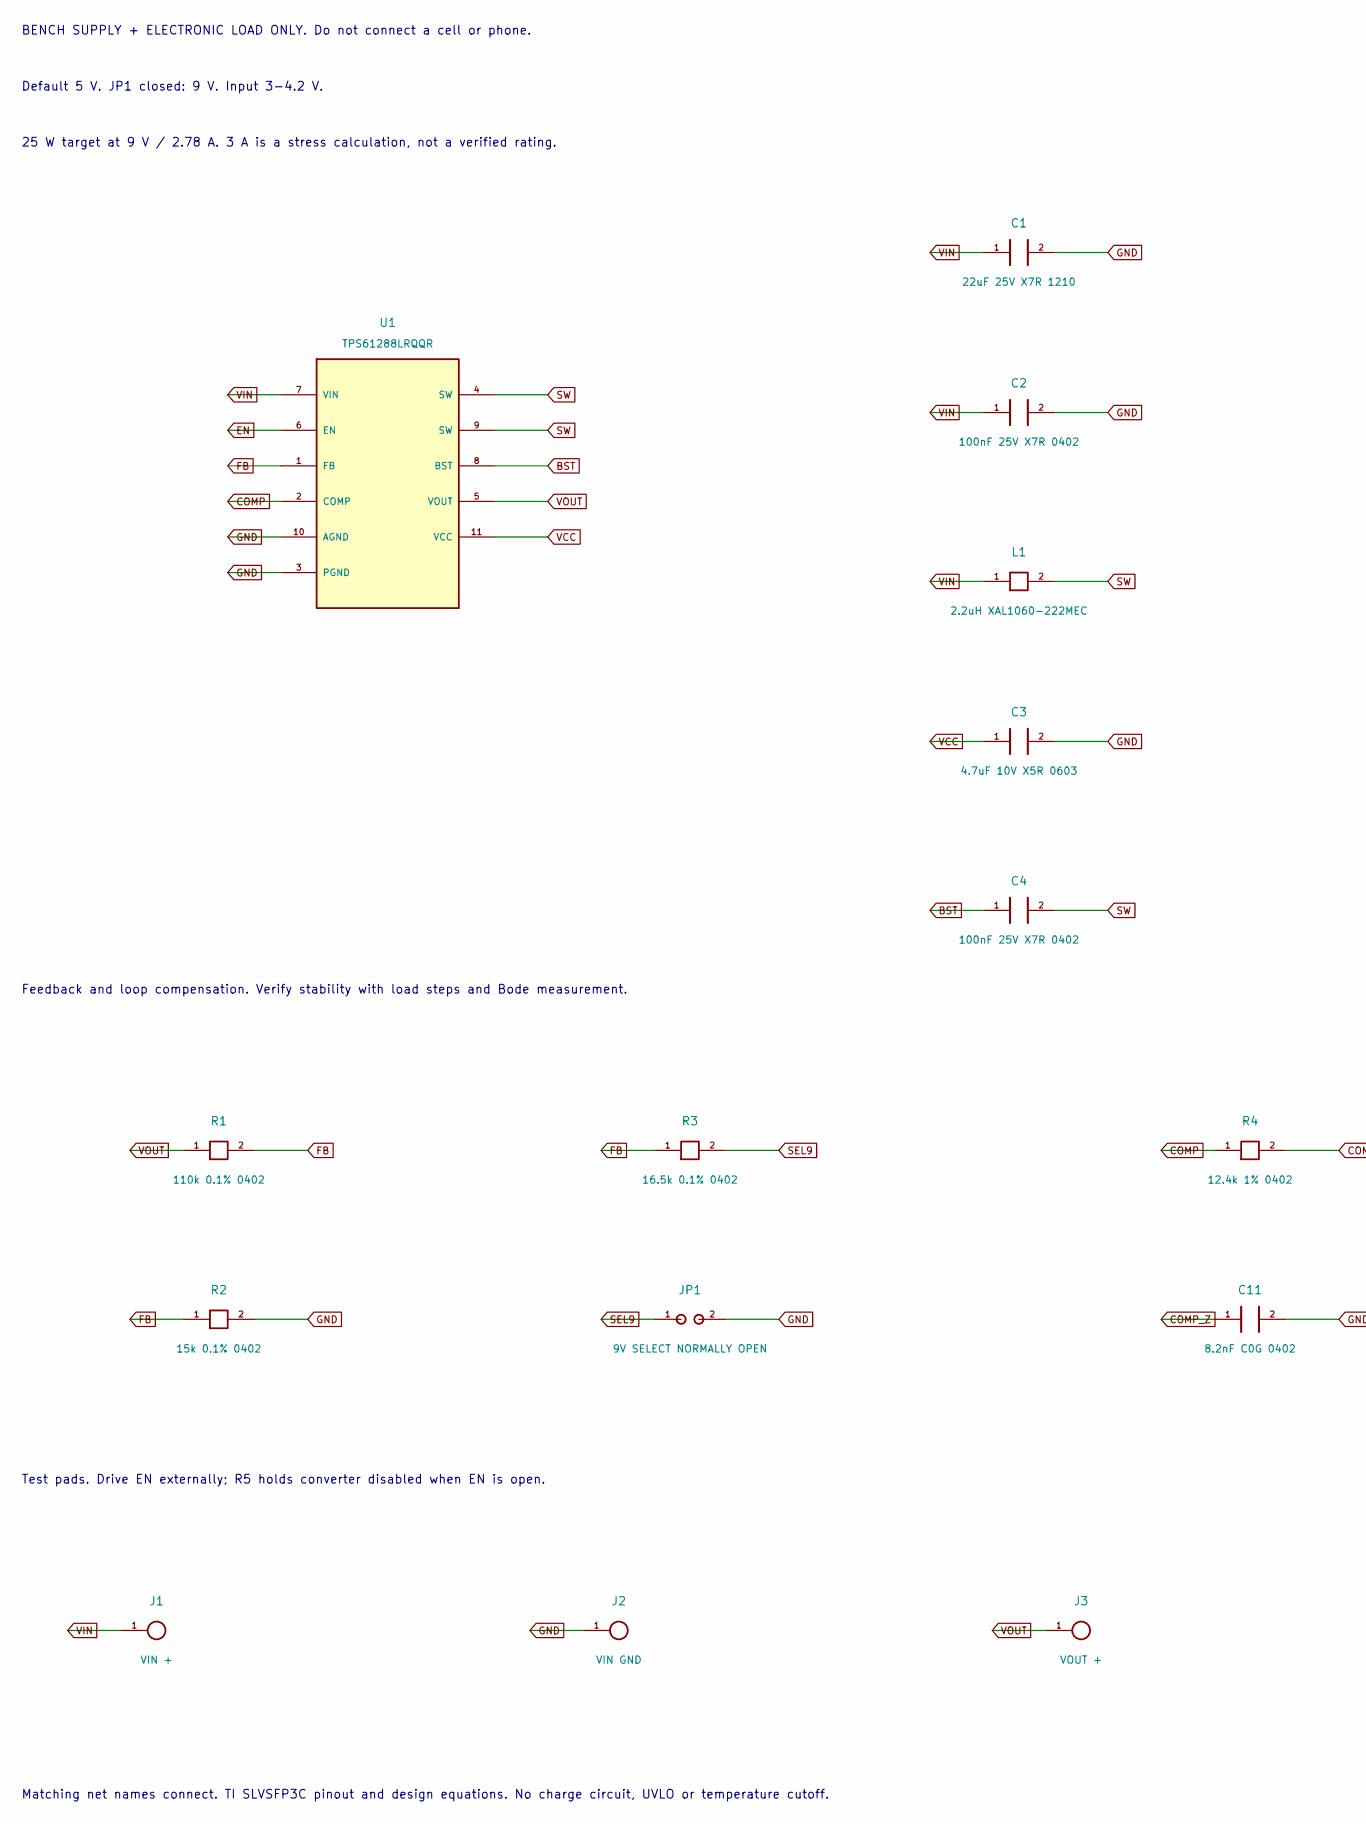
[picture p28: schematic spark_boost_rev_a.kicad_sch, Spark boost prototype Rev A, part in row 1, column 1]

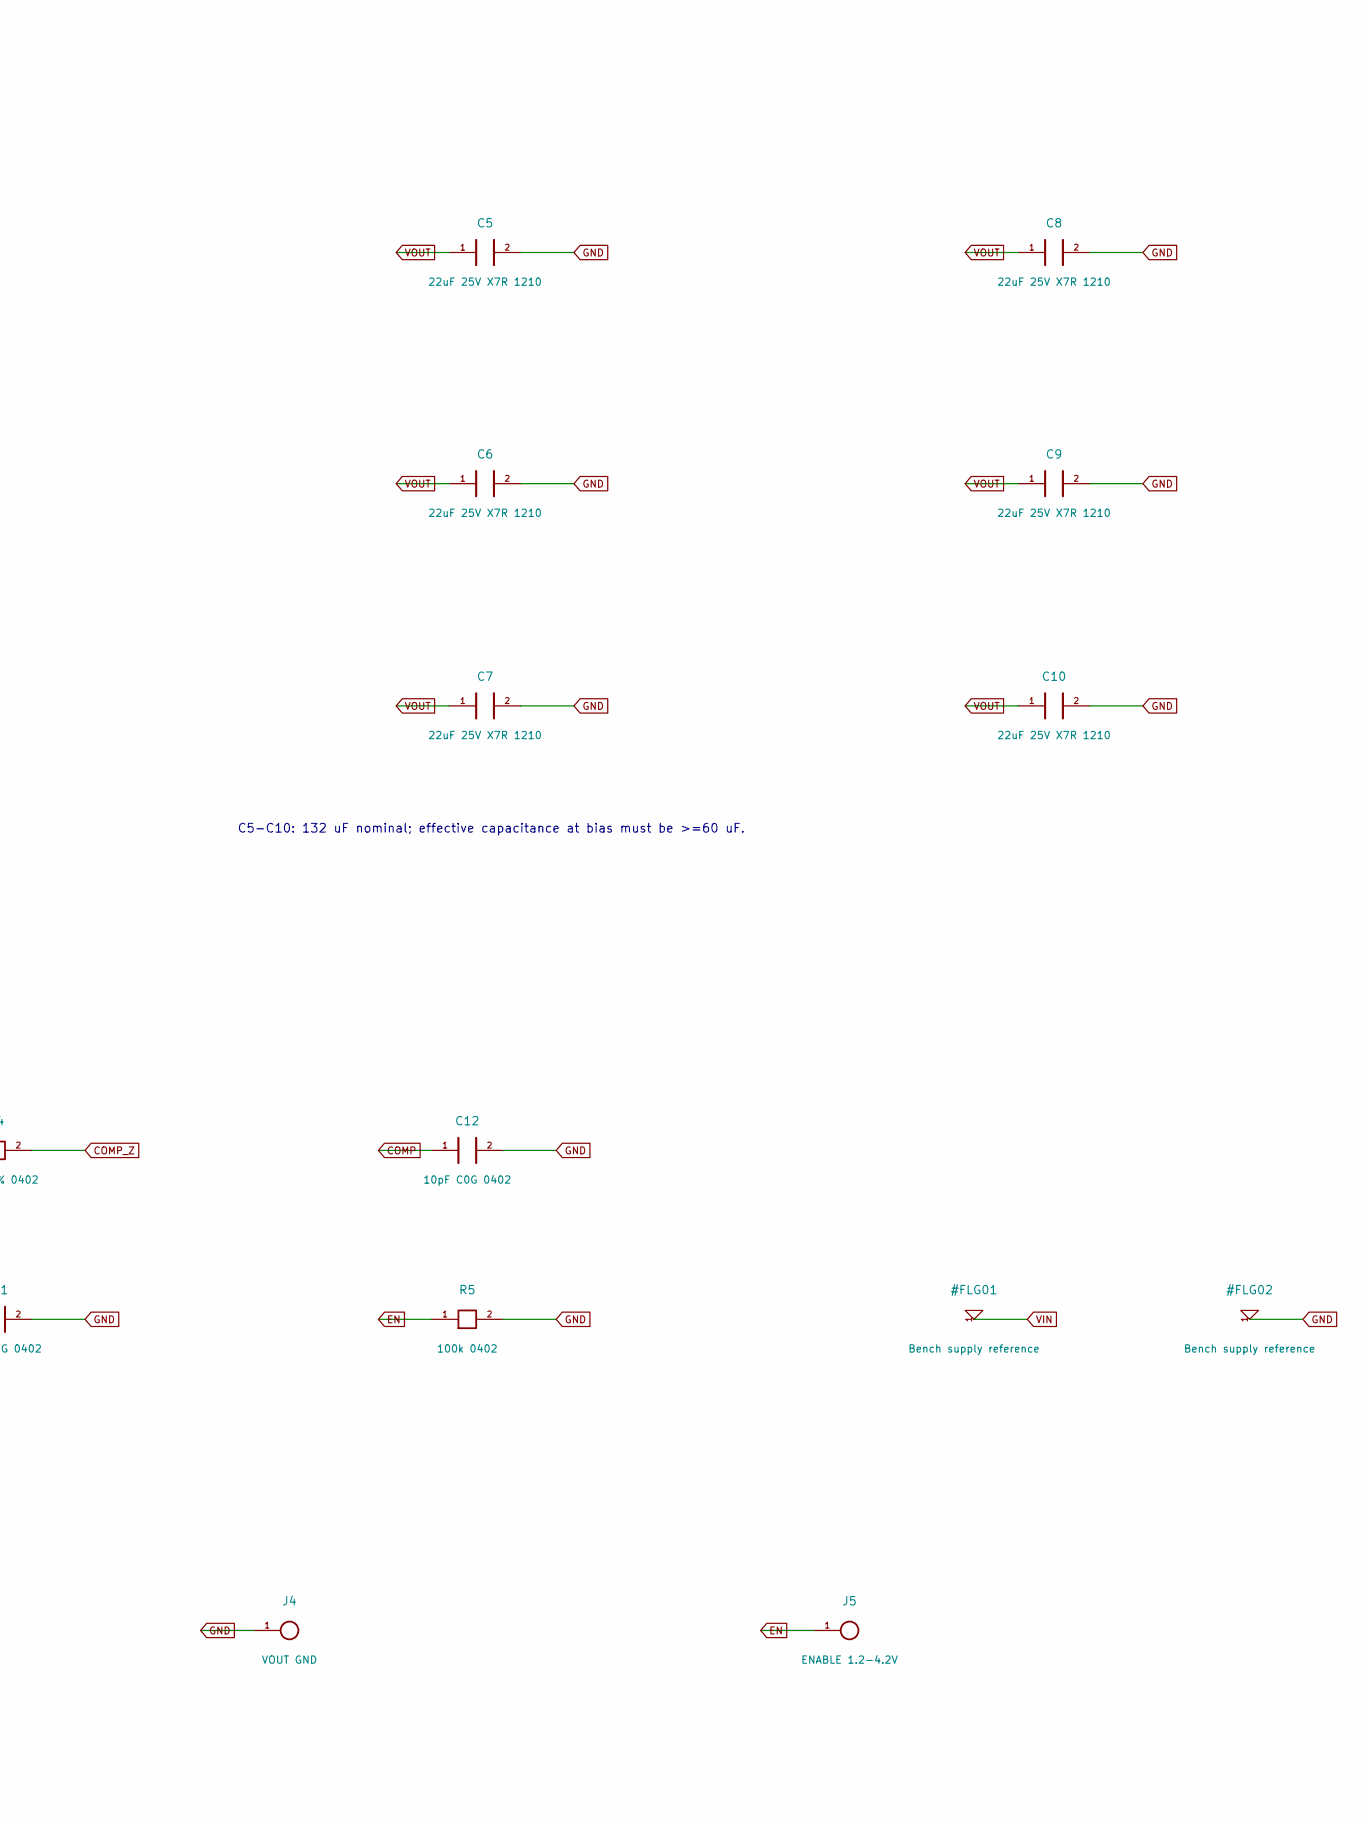
[picture p29: schematic spark_boost_rev_a.kicad_sch, Spark boost prototype Rev A, part in row 1, column 2]

Parts:
C1: 22uF 25V X7R 1210; C1_C_1210
C2: 100nF 25V X7R 0402; C2_C_0402
C3: 4.7uF 10V X5R 0603; C3_C_0603
C4: 100nF 25V X7R 0402; C4_C_0402
C5: 22uF 25V X7R 1210; C5_C_1210
C6: 22uF 25V X7R 1210; C6_C_1210
C7: 22uF 25V X7R 1210; C7_C_1210
C8: 22uF 25V X7R 1210; C8_C_1210
C9: 22uF 25V X7R 1210; C9_C_1210
C10: 22uF 25V X7R 1210; C10_C_1210
C11: 8.2nF C0G 0402; C11_C_0402
C12: 10pF C0G 0402; C12_C_0402
J1: VIN +; J1_WirePad
J2: VIN GND; J2_WirePad
J3: VOUT +; J3_WirePad
J4: VOUT GND; J4_WirePad
J5: ENABLE 1.2-4.2V; J5_WirePad
JP1: 9V SELECT NORMALLY OPEN; JP1_J_SolderJumper_OPEN
L1: 2.2uH XAL1060-222MEC; L1_Coilcraft_XAL1060
R1: 110k 0.1% 0402; R1_R_0402
R2: 15k 0.1% 0402; R2_R_0402
R3: 16.5k 0.1% 0402; R3_R_0402
R4: 12.4k 1% 0402; R4_R_0402
R5: 100k 0402; R5_R_0402
U1: TPS61288LRQQR; U1_TPS61288_RQQ0011A

Connections:
BST: C4.1, U1.8 (BST)
COMP: C12.1, R4.1, U1.2 (COMP)
COMP_Z: C11.1, R4.2
EN: J5.1, R5.1, U1.6 (EN)
FB: R1.2, R2.1, R3.1, U1.1 (FB)
GND: C1.2, C2.2, C3.2, C5.2, C6.2, C7.2, C8.2, C9.2, C10.2, C11.2, C12.2, J2.1, J4.1, JP1.2, R2.2, R5.2, U1.3 (PGND), U1.10 (AGND)
SEL9: JP1.1, R3.2
SW: C4.2, L1.2, U1.4 (SW), U1.9 (SW)
VCC: C3.1, U1.11 (VCC)
VIN: C1.1, C2.1, J1.1, L1.1, U1.7 (VIN)
VOUT: C5.1, C6.1, C7.1, C8.1, C9.1, C10.1, J3.1, R1.1, U1.5 (VOUT)

Notes on the sheet:
BENCH SUPPLY + ELECTRONIC LOAD ONLY. Do not connect a cell or phone.
Default 5 V. JP1 closed: 9 V. Input 3-4.2 V.
25 W target at 9 V / 2.78 A. 3 A is a stress calculation, not a verified rating.
C5-C10: 132 uF nominal; effective capacitance at bias must be >=60 uF.
Feedback and loop compensation. Verify stability with load steps and Bode measurement.
Test pads. Drive EN externally; R5 holds converter disabled when EN is open.
Matching net names connect. TI SLVSFP3C pinout and design equations. No charge circuit, UVLO or temperature cutoff.

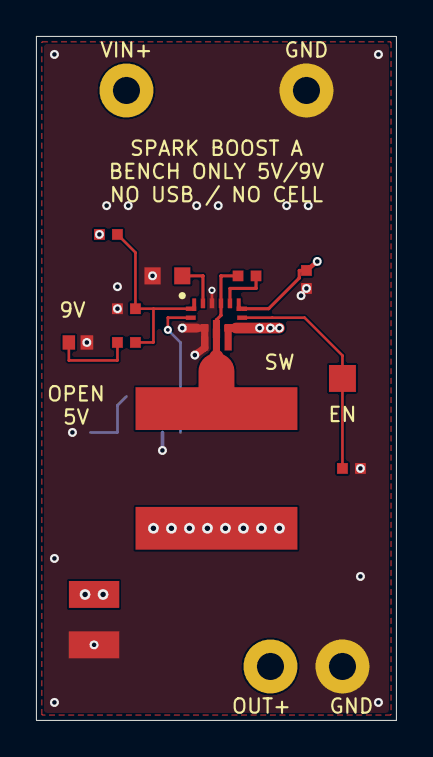
[picture p30: board spark_boost_rev_a.kicad_pcb from above]

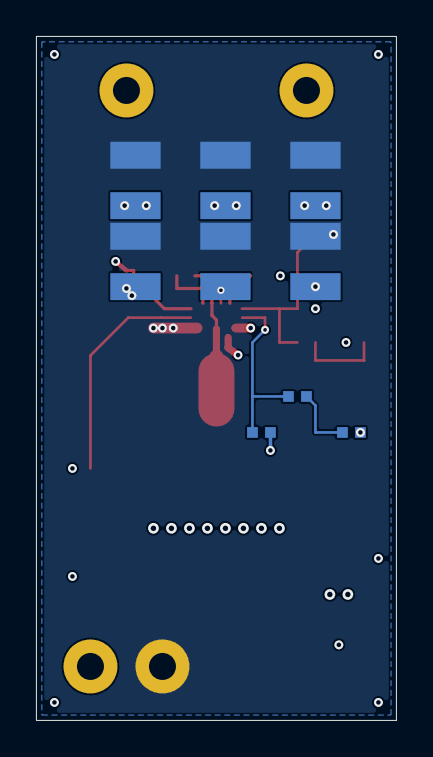
[picture p31: board spark_boost_rev_a.kicad_pcb from below]

Board: 4 copper layers, 20.0 x 38.0 mm, 25 parts (9 on the bottom side), 11 nets.
