hxssank/spark/(commit log)

2026-11-09 Publish reviewed source with setup and validation notes
    [BOM.csv, a30_unmeasured_reference.step, battery_reference.step, bottom_cap.step, c10_reference.step, c11_unmeasured_reference.step, c12_unmeasured_reference.step, c2_unmeasured_reference.step]
2026-11-09 docs: publish CAD and fabrication files with parts and validation scope
    [bottom_cap.stl, carrier.stl, front_cover.stl, pcb-drc.json, sleeve.stl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]
